ararobo/GN10Mainboard/KiCad/GN10Mainboard/kicad_lib/3dmodels/SI-60062.step

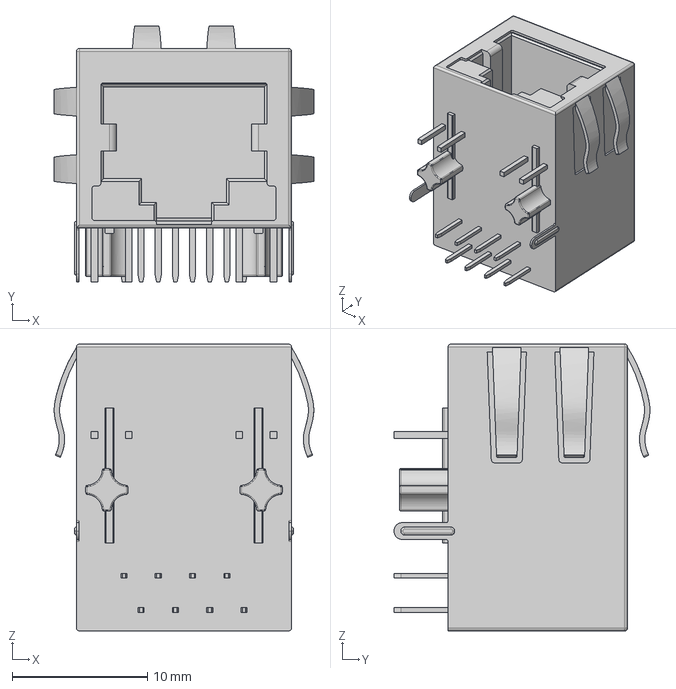
[picture p2: CAD file, 2025-08-13]
KiCad/GN10Mainboard/kicad_lib/3dmodels/SI-60062.step
19.2 x 18.9 x 21.2 mm
