ararobo/GN10Mainboard/KiCad/GN10Mainboard/kicad_lib/3dmodels/WBZ451_LGA_REV3P0-WOUFL.step

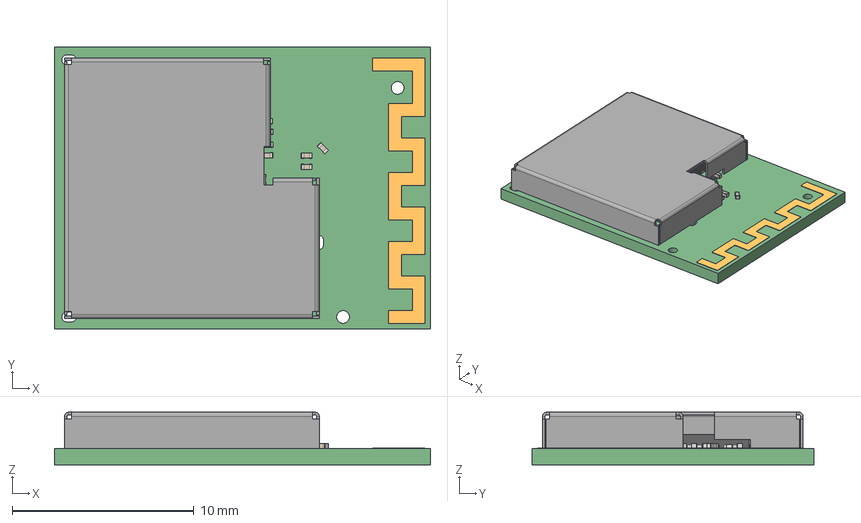
[picture p3: CAD file, 2025-01-28]
KiCad/GN10Mainboard/kicad_lib/3dmodels/WBZ451_LGA_REV3P0-WOUFL.step
20.7 x 15.5 x 2.90 mm
CAP_C_0402 x 5
User_Library-SMD_RESISTOR-10201 x 6
User_Library-Chip_Resistor2 x 3
IND_C_0402 x 2
microchip_shield_blsh_Rev04_RGB6710886
User_Library-SMD_CAPACITOR x 23
Extruded x 2
IND_C_0805
ABM11
User_Library-QFN48_7x7
