ararobo/GN10Mainboard/KiCad/GN10Mainboard/kicad_lib/3dmodels/TVAF06-A020B-R_v2.step

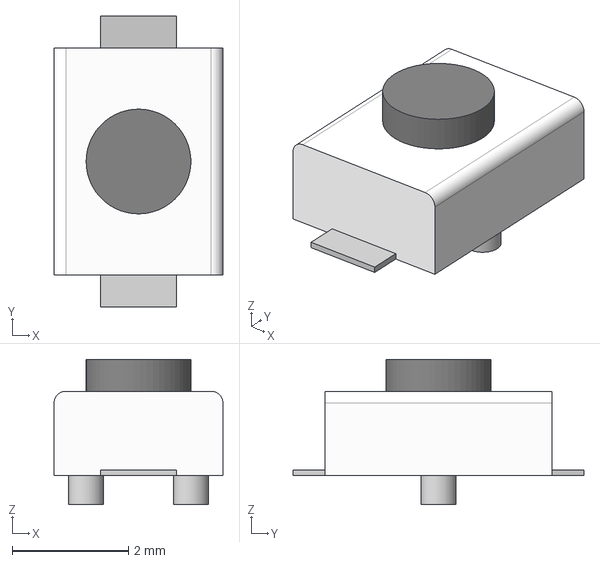
[picture p4: CAD file, 2025-01-28]
KiCad/GN10Mainboard/kicad_lib/3dmodels/TVAF06-A020B-R_v2.step
2.90 x 5.00 x 2.50 mm
