ararobo/GN10Mainboard/KiCad/GN10Mainboard/kicad_lib/3dmodels/mps_dcdc_okl_t6_a.step

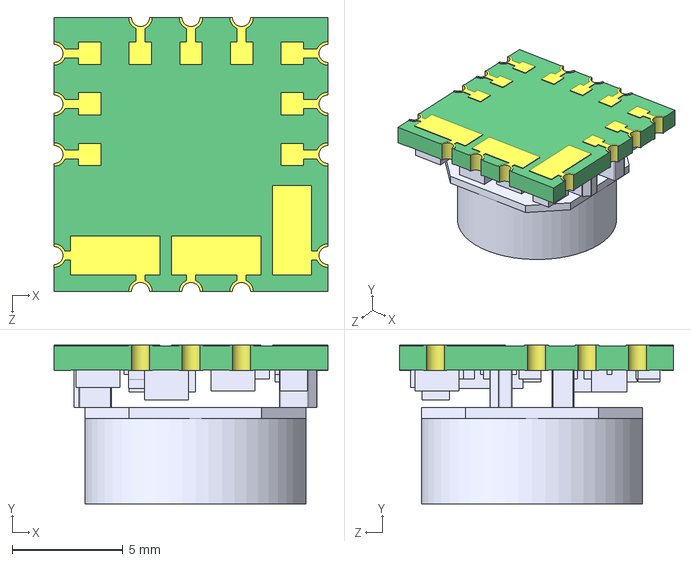
[picture p5: CAD file, 2025-01-28]
KiCad/GN10Mainboard/kicad_lib/3dmodels/mps_dcdc_okl_t6_a.step
12.4 x 7.19 x 12.4 mm
