ararobo/GN10Mainboard/KiCad/GN10Mainboard/kicad_lib/3dmodels/Type-C.STEP

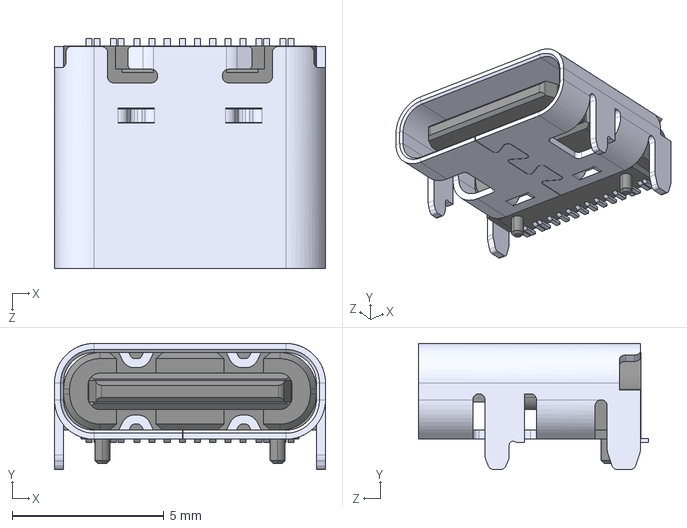
[picture p6: CAD file, 2025-01-28]
KiCad/GN10Mainboard/kicad_lib/3dmodels/Type-C.STEP
8.94 x 4.16 x 7.60 mm
