ararobo/GN10Mainboard/KiCad/GN10Mainboard/GN10Mainboard.pdf

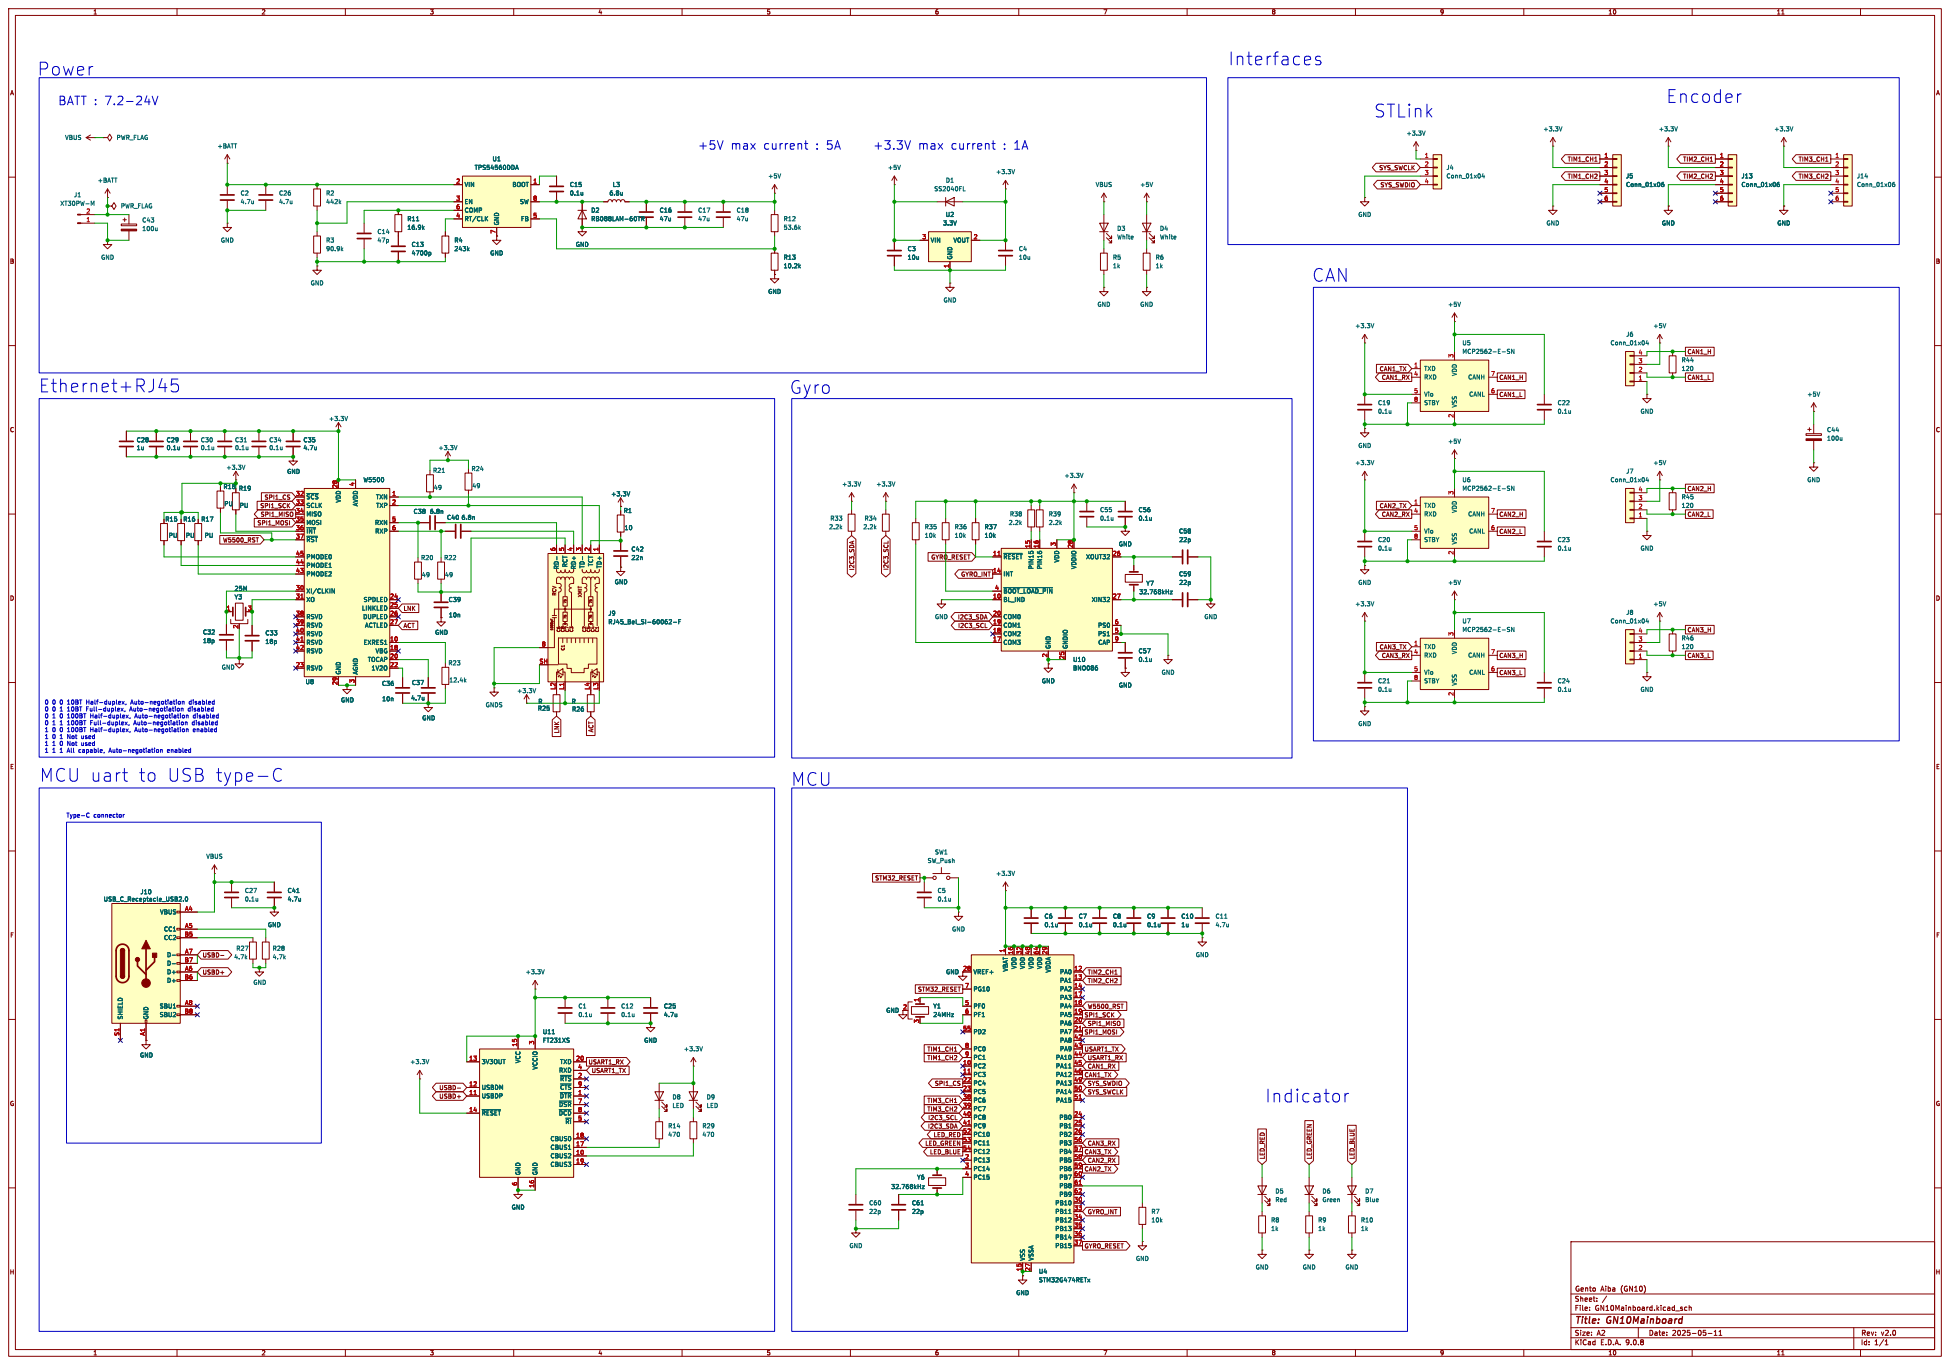
[picture p7: page 1]

3 TXN 1 TXP 2 RXN 5 RXP 6 SPDLED 24

LINKLED 25 DUPLED 26 ACTLED 27 EXRES1 10 VBG 18 TOCAP 20

1 0 1 Not used
1 1 0 Not used
MCU uart to USB type-C

1 VDD 16 VDD 32 VSS 15 VDD 48 VSSA 27 VDD 64 VDDA 29 PA0 12 PA1 13 PA2 14 PA3 17 PA4 18 PA5 19 PA6 20 PA7 21 PA8 42 PA9 43 PA10 44 PA11 45 PA12 46 PA13 49 PA14 50 PA15 51 PB0 24 PB1 25 PB2 26 PB3 56 PB4 57 PB5 58 PB6 59 PB7 60 PB8 61 PB9 62 PB10 30 PB11 33 PB12 34 PB13 35 PB14 36 PB15 37 U4STM32G474RETx

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

3 GND 16 TXD 20 RXD 4 ~{RTS}2 ~{CTS}9 ~{DTR}1 ~{DSR}7 ~{DCD}8 ~{RI}5 CBUS0 18 CBUS1 17 CBUS2 10 CBUS3 19 C25

3 GND 16 TXD 20 RXD 4 ~{RTS}2 ~{CTS}9 ~{DTR}1 ~{DSR}7 ~{DCD}8 ~{RI}5 CBUS0 18 CBUS1 17 CBUS2 10 CBUS3 19 U11 FT231XS

File: GN10Mainboard.kicad_sch Sheet: / Gento Aiba (GN10)
