ararobo/GN10Mainboard/KiCad/GN10Mainboard/GN10Mainboard.kicad_pcb

## KiCad design KiCad/GN10Mainboard/GN10Mainboard.kicad_pcb (2025-12-31)

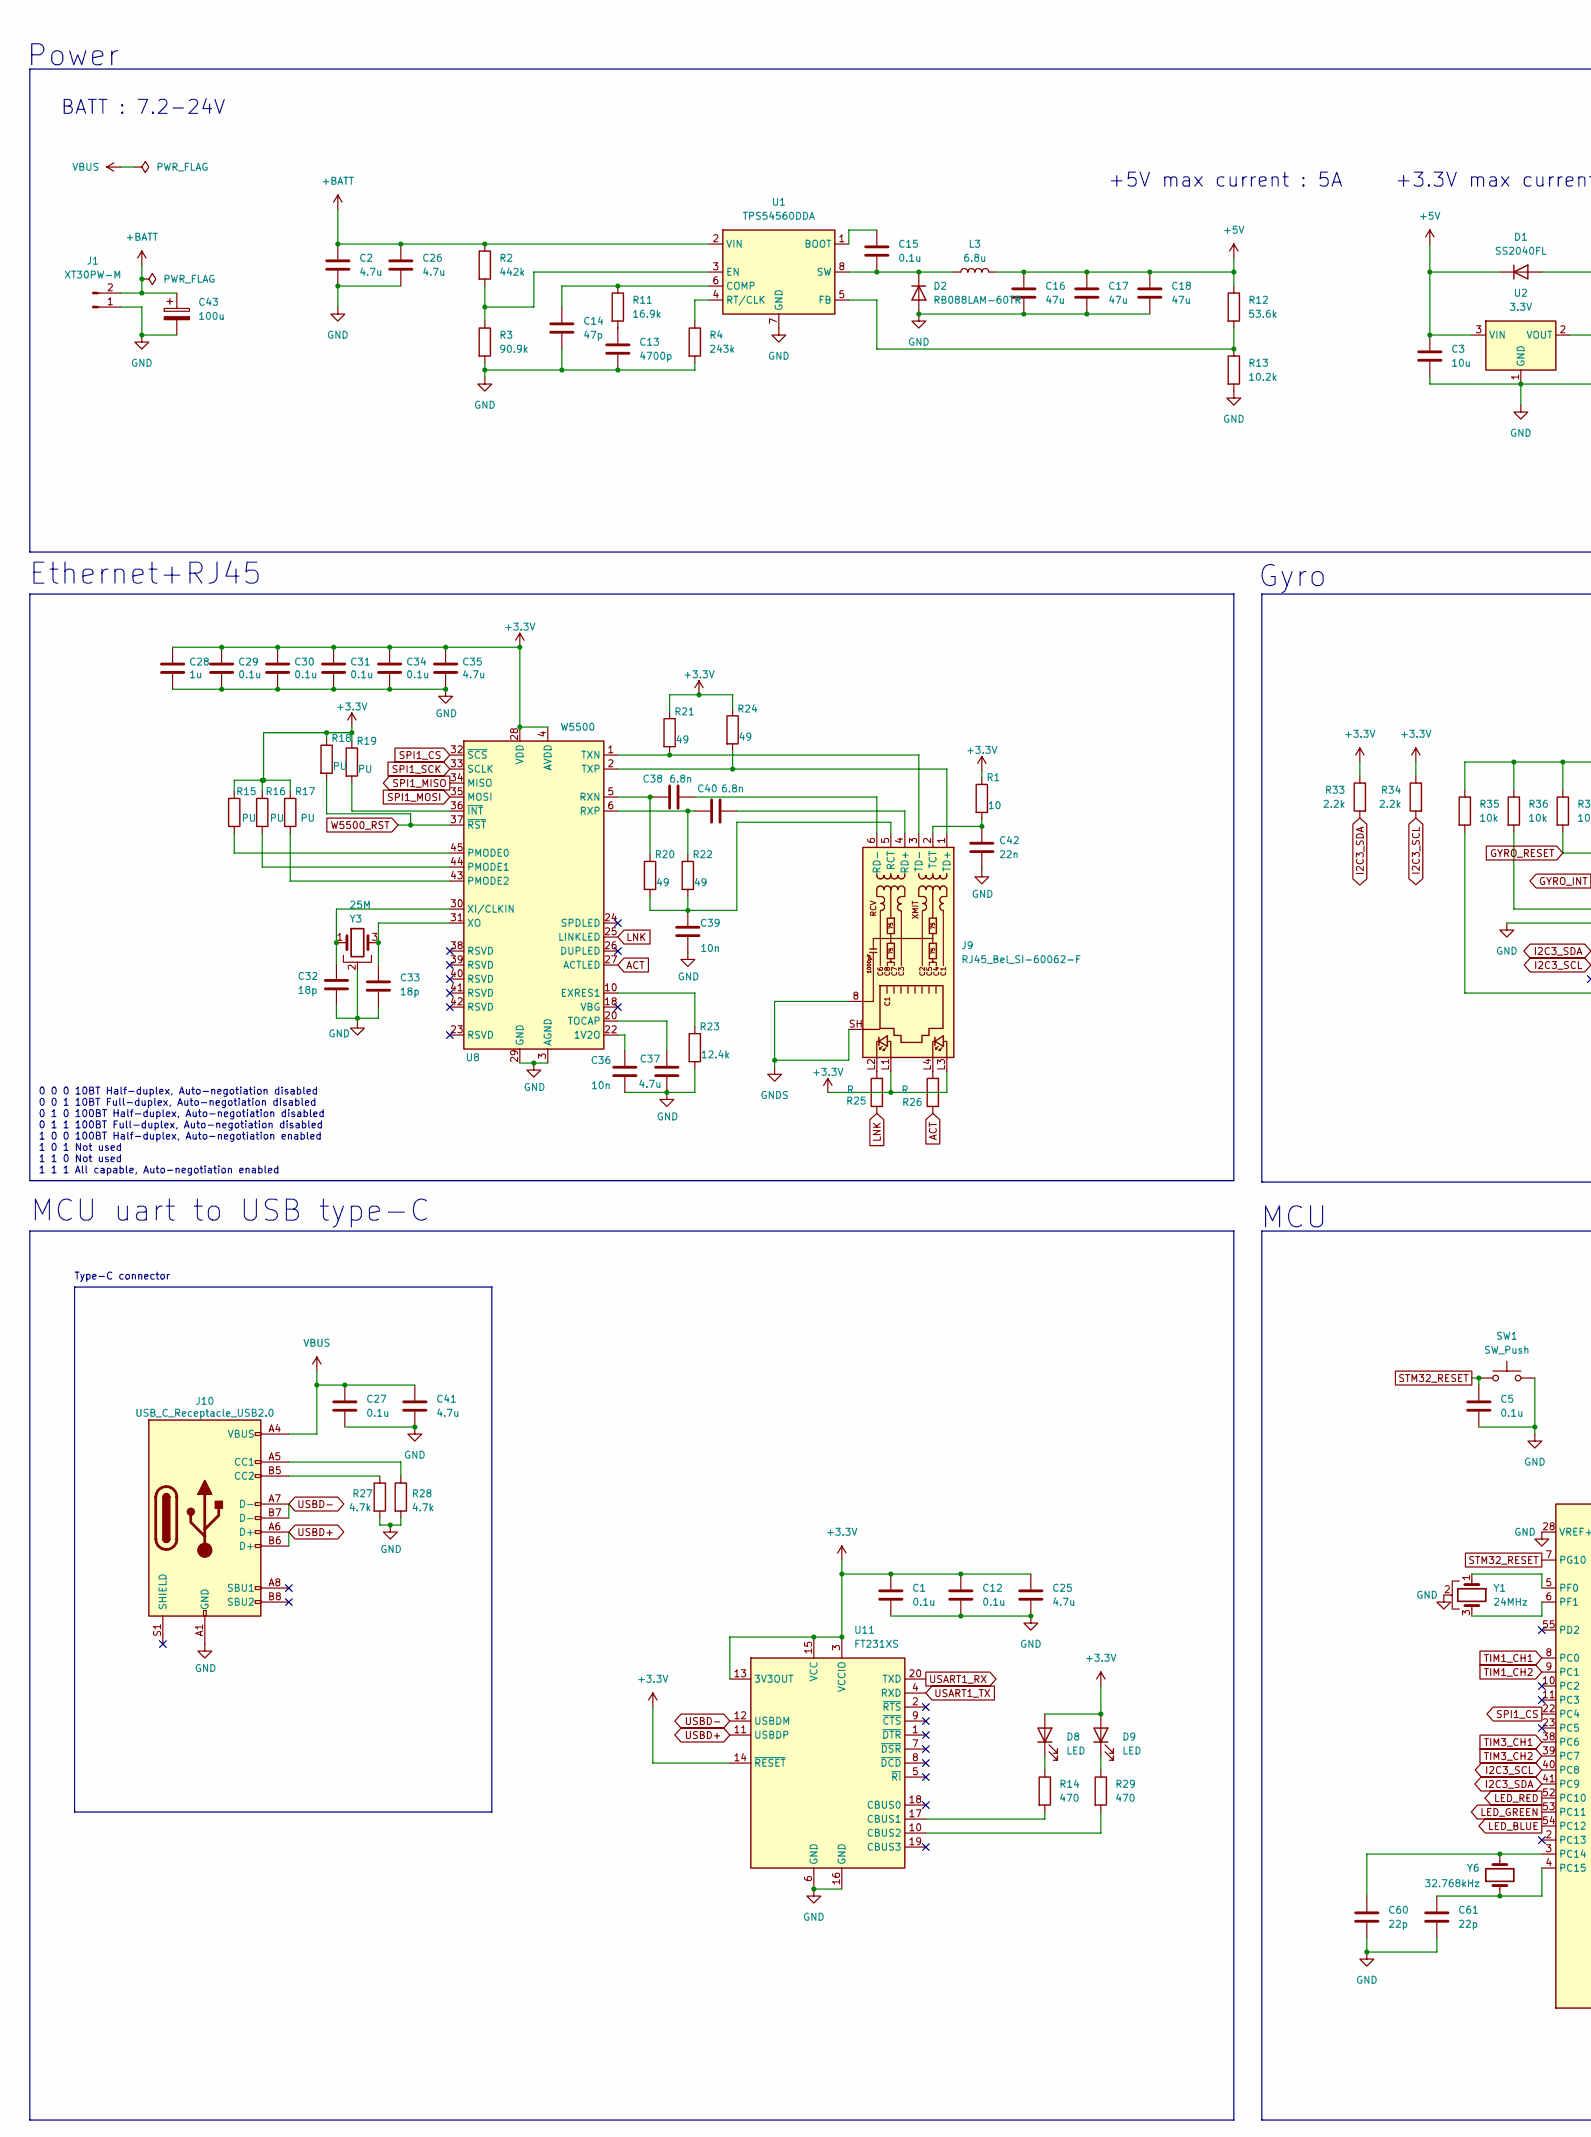
[picture p8: schematic GN10Mainboard.kicad_sch, part in row 1, column 1]

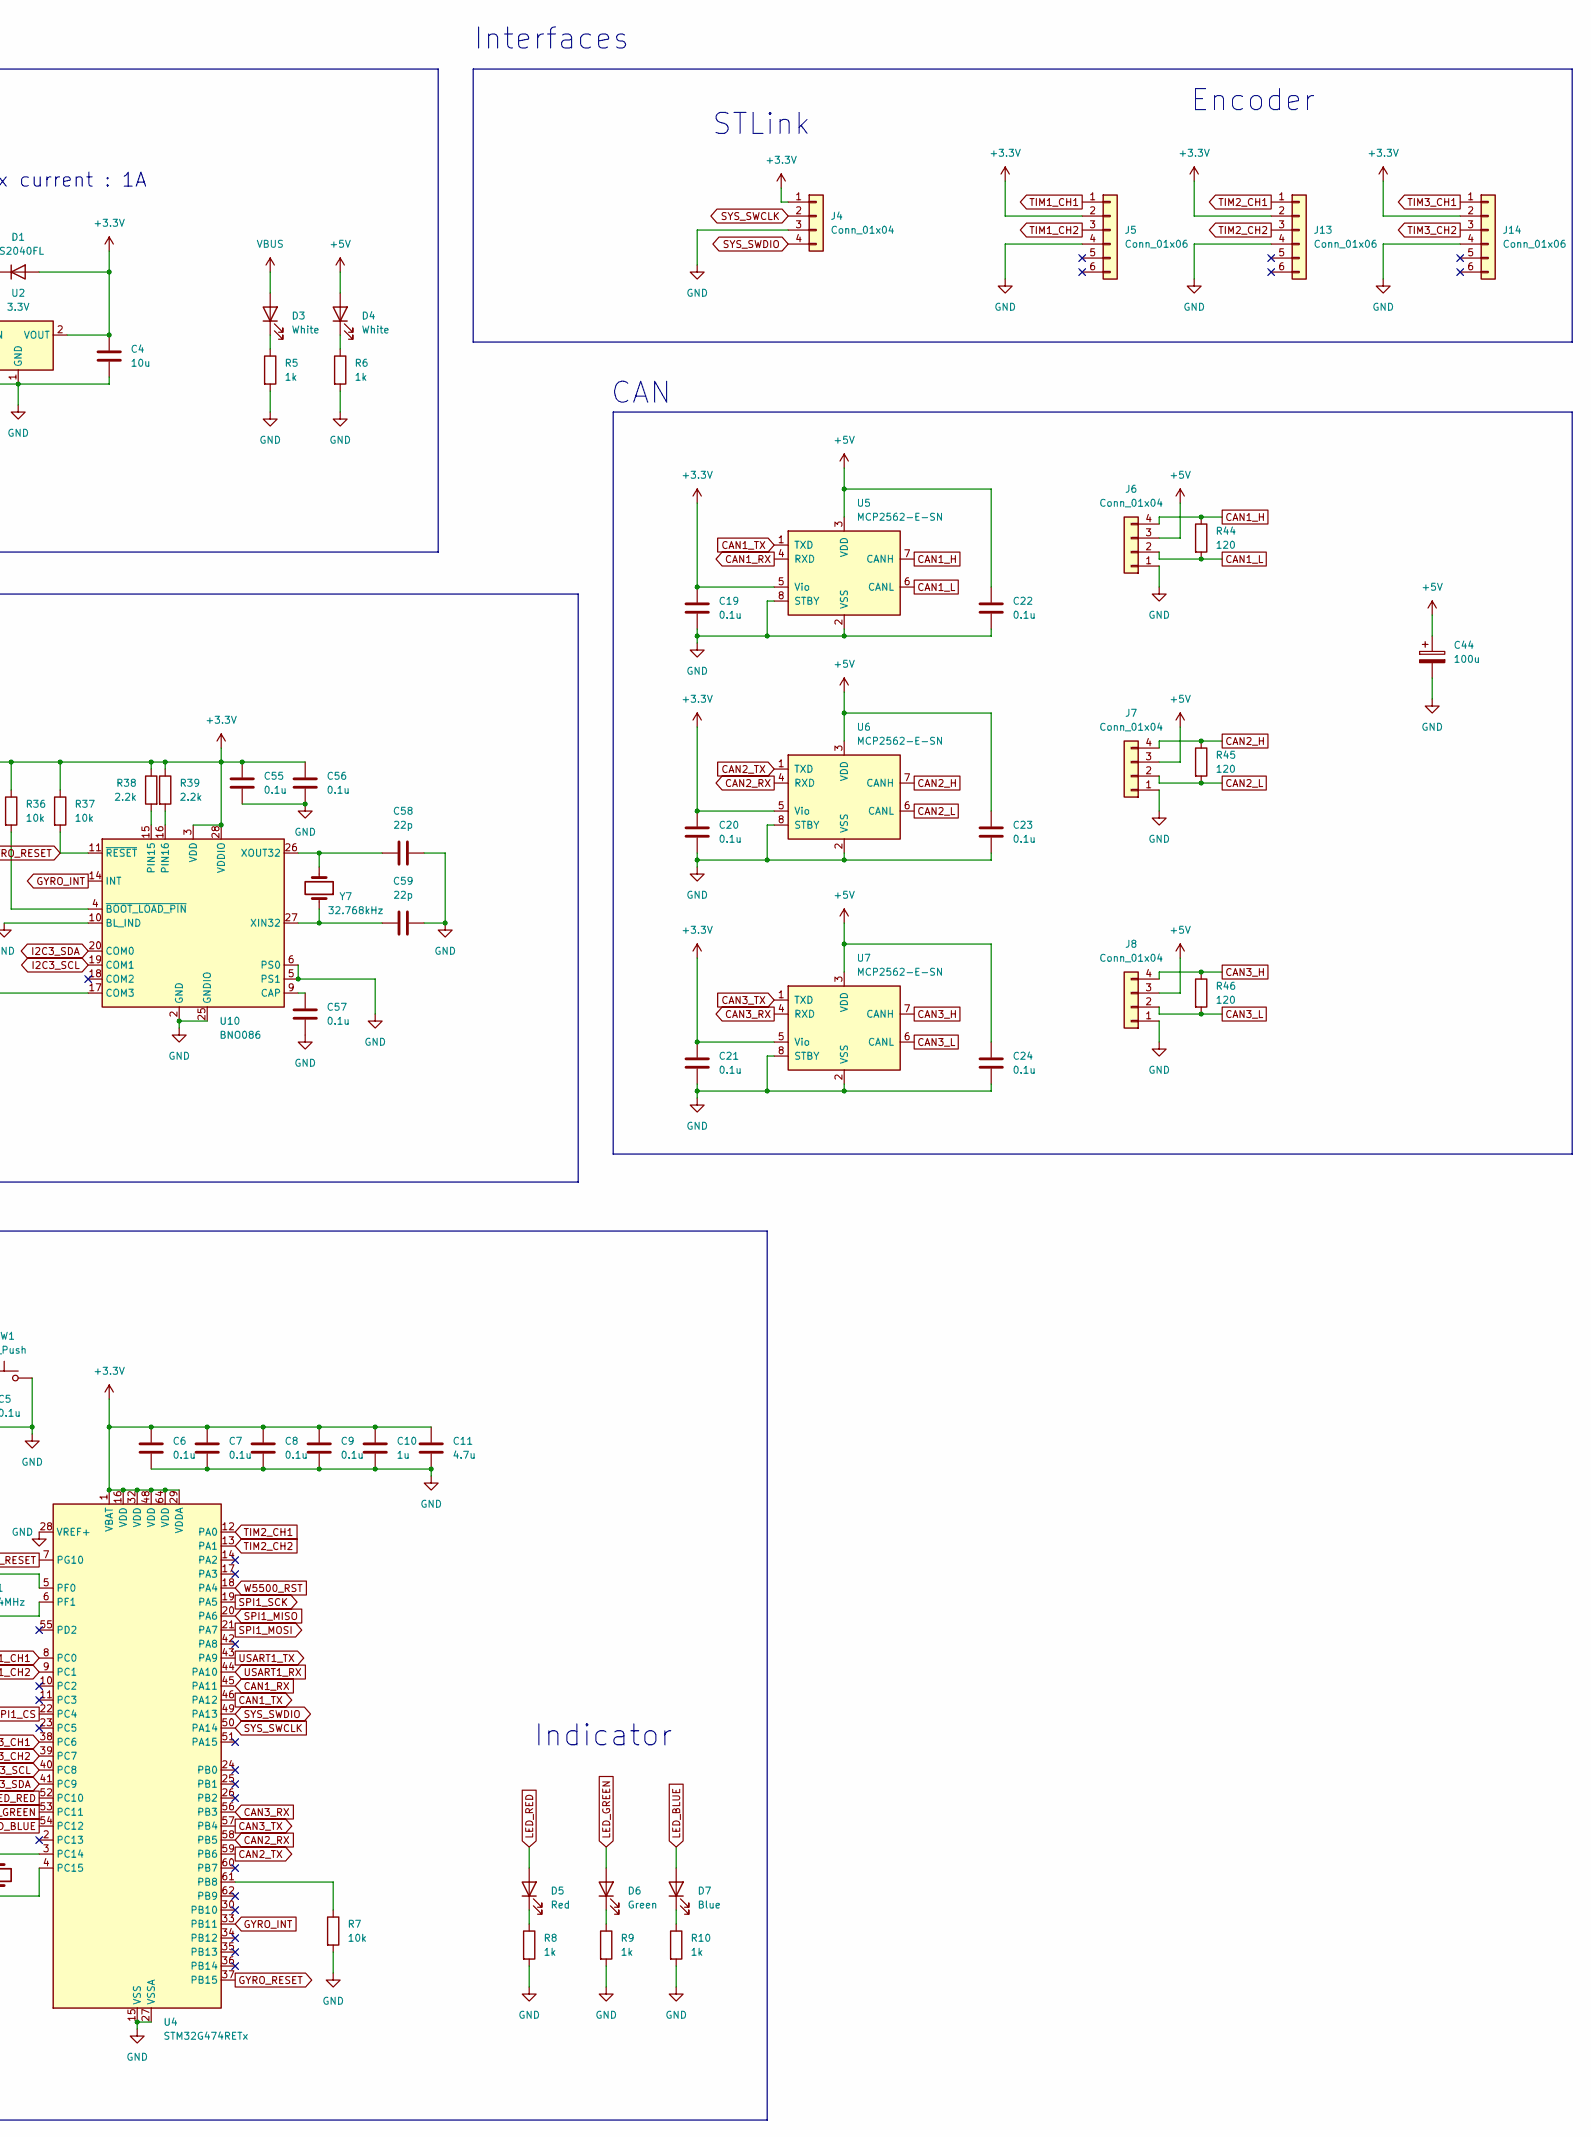
[picture p9: schematic GN10Mainboard.kicad_sch, part in row 1, column 2]

Parts:
C1, C5, C6, C7, C8, C9, C12, C15, C19, C20, C21, C22, C23, C24, C27, C29, C30, C31, C34, C55, C56, C57: 0.1u; C_0402_1005Metric
C2, C26: 4.7u; C_1210_3225Metric
C3, C4: 10u; C_0603_1608Metric
C10, C28: 1u; C_0402_1005Metric
C11, C35, C37: 4.7u; C_0402_1005Metric
C13: 4700p; C_0402_1005Metric
C14: 47p; C_0402_1005Metric
C16, C17, C18: 47u; C_1210_3225Metric
C25, C41: 4.7u; C_0603_1608Metric
C32, C33: 18p; C_0402_1005Metric
C36, C39: 10n; C_0402_1005Metric
C38, C40: 6.8n; C_0402_1005Metric
C42: 22n; C_0402_1005Metric
C43, C44: 100u; CP_Radial_D8.0mm_P3.50mm
C58, C59, C60, C61: 22p; C_0402_1005Metric
D1: SS2040FL; Nexperia_CFP3_SOD-123W
D2: RB088LAM-60TR; D_SOD-128
D3, D4: White; LED_0603_1608Metric
D5: Red; LED_0603_1608Metric
D6: Green; LED_0603_1608Metric
D7: Blue; LED_0603_1608Metric
D8, D9: LED; LED_0603_1608Metric
J1: XT30PW-M; AMASS_XT30U-M_1x02_P5.0mm_Vertical
J4, J6, J7, J8: Conn_01x04; JST_XH_B4B-XH-A_1x04_P2.50mm_Vertical
J5, J13, J14: Conn_01x06; JST_XH_B6B-XH-A_1x06_P2.50mm_Vertical
J9: RJ45_Bel_SI-60062-F
J10: USB_C_Receptacle_USB2.0; USB_C_Receptacle_HRO_TYPE-C-31-M-12
L3: 6.8u; L_Coilcraft_XAL6060-XXX
R1: 10; R_0402_1005Metric
R2: 442k; R_0402_1005Metric
R3: 90.9k; R_0402_1005Metric
R4: 243k; R_0402_1005Metric
R5, R6, R8, R9, R10: 1k; R_0402_1005Metric
R7, R35, R36, R37: 10k; R_0402_1005Metric
R11: 16.9k; R_0402_1005Metric
R12: 53.6k; R_0402_1005Metric
R13: 10.2k; R_0402_1005Metric
R14, R29: 470; R_0402_1005Metric
R15, R16, R17, R18, R19: PU; R_0402_1005Metric
R20, R21, R22, R24: 49; R_0402_1005Metric
R23: 12.4k; R_0402_1005Metric
R25, R26: R; R_0402_1005Metric
R27, R28: 4.7k; R_0402_1005Metric
R33, R34, R38, R39: 2.2k; R_0402_1005Metric
R44, R45, R46: 120; R_0402_1005Metric
SW1: SW_Push; TVAF
U1: TPS54560DDA; Texas_R-PDSO-G8_EP2.95x4.9mm_Mask2.4x3.1mm_ThermalVias
U2: 3.3V; SOT-223-3_TabPin2
U4: STM32G474RETx; LQFP-64_10x10mm_P0.5mm
U5, U6, U7: MCP2562-E-SN; SOIC-8_3.9x4.9mm_P1.27mm
U8: W5500; LQFP-48_7x7mm_P0.5mm
U10: BNO086; LGA-28_5.2x3.8mm_P0.5mm
U11: FT231XS; SSOP-20_3.9x8.7mm_P0.635mm
Y1: 24MHz; Resonator_SMD_Murata_CSTxExxV-3Pin_3.0x1.1mm
Y3: 25M; Crystal_SMD_2016-4Pin_2.0x1.6mm
Y6, Y7: 32.768kHz; Crystal_SMD_3215-2Pin_3.2x1.5mm

Connections:
+3.3V: C1.1, C4.1, C6.1, C7.1, C8.1, C9.1, C10.1, C11.1, C12.1, C19.1, C20.1, C21.1, C25.1, C28.1, C29.1, C30.1, C31.1, C34.1, C35.1, C55.1, C56.1, D1.2 (A), D8.2 (A), D9.2 (A), J4.1, J5.2, J9.L1, J9.L3, J13.2, J14.2, R1.1, R15.1, R16.1, R17.1, R18.1, R19.1, R21.1, R24.1, R33.1, R34.1, R35.1, R36.1, R37.1, R38.1, R39.1, U2.2 (VOUT), U4.1 (VBAT), U4.16 (VDD), U4.29 (VDDA), U4.32 (VDD), U4.48 (VDD), U4.64 (VDD), U5.5 (Vio), U6.5 (Vio), U7.5 (Vio), U8.4 (AVDD), U8.8 (AVDD), U8.11 (AVDD), U8.15 (AVDD), U8.17 (AVDD), U8.21 (AVDD), U8.28 (VDD), U10.3 (VDD), U10.28 (VDDIO), U11.3 (VCCIO), U11.13 (3V3OUT), U11.14 (~RESET), U11.15 (VCC)
+5V: C3.1, C16.1, C17.1, C18.1, C22.1, C23.1, C24.1, C44.1, D1.1 (K), D4.2 (A), J6.3, J7.3, J8.3, L3.2, R12.1, U2.3 (VIN), U5.3 (VDD), U6.3 (VDD), U7.3 (VDD)
+BATT: C2.1, C26.1, C43.1, J1.2, R2.1, U1.2 (VIN)
ACT: R26.1, U8.27 (ACTLED)
CAN1_H: J6.4, R44.1, U5.7 (CANH)
CAN1_L: J6.2, R44.2, U5.6 (CANL)
CAN1_RX: U4.45 (PA11), U5.4 (RXD)
CAN1_TX: U4.46 (PA12), U5.1 (TXD)
CAN2_H: J7.4, R45.1, U6.7 (CANH)
CAN2_L: J7.2, R45.2, U6.6 (CANL)
CAN2_RX: U4.58 (PB5), U6.4 (RXD)
CAN2_TX: U4.59 (PB6), U6.1 (TXD)
CAN3_H: J8.4, R46.1, U7.7 (CANH)
CAN3_L: J8.2, R46.2, U7.6 (CANL)
CAN3_RX: U4.56 (PB3), U7.4 (RXD)
CAN3_TX: U4.57 (PB4), U7.1 (TXD)
GND: C1.2, C2.2, C3.2, C4.2, C5.2, C6.2, C7.2, C8.2, C9.2, C10.2, C11.2, C12.2, C13.2, C14.2, C16.2, C17.2, C18.2, C19.2, C20.2, C21.2, C22.2, C23.2, C24.2, C25.2, C26.2, C27.2, C28.2, C29.2, C30.2, C31.2, C32.2, C33.2, C34.2, C35.2, C36.2, C37.2, C39.2, C41.2, C42.2, C43.2, C44.2, C55.2, C56.2, C57.2, C58.2, C59.2, C60.1, C61.1, D2.2 (A), J1.1, J4.3, J5.4, J6.1, J7.1, J8.1, J10.A1 (GND), J10.A12 (GND), J10.B1 (GND), J10.B12 (GND), J13.4, J14.4, R3.2, R4.2, R5.2, R6.2, R7.2, R8.2, R9.2, R10.2, R13.2, R23.2, R27.2, R28.2, SW1.2, U1.7 (GND), U1.9 (GND), U2.1 (GND), U4.15 (VSS), U4.27 (VSSA), U4.28 (VREF+), U4.31 (VSS), U4.47 (VSS), U4.63 (VSS), U5.2 (VSS), U5.8 (STBY), U6.2 (VSS), U6.8 (STBY), U7.2 (VSS), U7.8 (STBY), U8.3 (AGND), U8.9 (AGND), U8.14 (AGND), U8.16 (AGND), U8.19 (AGND), U8.29 (GND), U8.48 (AGND), U10.2 (GND), U10.5 (PS1), U10.6 (PS0), U10.10 (BL_IND), U10.25 (GNDIO), U11.6 (GND), U11.16 (GND), Y1.2, Y3.2
GNDS: J9.8, J9.SH
GYRO_INT: U4.33 (PB11), U10.14 (INT)
GYRO_RESET: R37.2, U4.37 (PB15), U10.11 (~RESET)
I2C3_SCL: R34.2, U4.40 (PC8), U10.19 (COM1)
I2C3_SDA: R33.2, U4.41 (PC9), U10.20 (COM0)
LED_BLUE: D7.2 (A), U4.54 (PC12)
LED_GREEN: D6.2 (A), U4.53 (PC11)
LED_RED: D5.2 (A), U4.52 (PC10)
LNK: R25.1, U8.25 (LINKLED)
unnamed: C13.1, R11.2
unnamed: C15.2, D2.1 (K), L3.1, U1.8 (SW)
unnamed: D3.1 (K), R5.1
unnamed: D4.1 (K), R6.1
unnamed: D5.1 (K), R8.1
unnamed: D6.1 (K), R9.1
unnamed: D7.1 (K), R10.1
unnamed: D8.1 (K), R14.1
unnamed: D9.1 (K), R29.1
unnamed: J9.L2, R25.2
unnamed: J9.L4, R26.2
unnamed: C39.1, J9.5 (RCT), R20.2, R22.2
unnamed: C40.2, J9.4 (RD+)
unnamed: C38.1, J9.6 (RD-)
unnamed: C42.1, J9.2 (TCT), R1.2
unnamed: J9.1 (TD+), R24.2, U8.2 (TXP)
unnamed: J9.3 (TD-), R21.2, U8.1 (TXN)
unnamed: J10.A5 (CC1), R28.1
unnamed: J10.B5 (CC2), R27.1
unnamed: C15.1, U1.1 (BOOT)
unnamed: C14.1, R11.1, U1.6 (COMP)
unnamed: R2.2, R3.1, U1.3 (EN)
unnamed: R12.2, R13.1, U1.5 (FB)
unnamed: R4.1, U1.4 (RT/CLK)
unnamed: R7.1, U4.61 (PB8)
unnamed: C60.2, U4.3 (PC14), Y6.2
unnamed: C61.2, U4.4 (PC15), Y6.1
unnamed: U4.5 (PF0), Y1.1
unnamed: U4.6 (PF1), Y1.3
unnamed: C36.1, U8.22 (1V2O)
unnamed: R23.1, U8.10 (EXRES1)
unnamed: R15.2, U8.45 (PMODE0)
unnamed: R16.2, U8.44 (PMODE1)
unnamed: R17.2, U8.43 (PMODE2)
unnamed: C38.2, R20.1, U8.5 (RXN)
unnamed: C40.1, R22.1, U8.6 (RXP)
unnamed: C37.1, U8.20 (TOCAP)
unnamed: C32.1, U8.30 (XI/CLKIN), Y3.1
unnamed: C33.1, U8.31 (XO), Y3.3
unnamed: R19.2, U8.36 (~INT)
unnamed: C57.1, U10.9 (CAP)
unnamed: R35.2, U10.17 (COM3)
unnamed: R38.2, U10.15 (PIN15)
unnamed: R39.2, U10.16 (PIN16)
unnamed: C59.1, U10.27 (XIN32), Y7.1
unnamed: C58.1, U10.26 (XOUT32), Y7.2
unnamed: R36.2, U10.4 (~BOOT_LOAD_PIN)
unnamed: R14.2, U11.17 (CBUS1)
unnamed: R29.2, U11.10 (CBUS2)
SPI1_CS: U4.22 (PC4), U8.32 (~SCS)
SPI1_MISO: U4.20 (PA6), U8.34 (MISO)
SPI1_MOSI: U4.21 (PA7), U8.35 (MOSI)
SPI1_SCK: U4.19 (PA5), U8.33 (SCLK)
STM32_RESET: C5.1, SW1.1, U4.7 (PG10)
SYS_SWCLK: J4.2, U4.50 (PA14)
SYS_SWDIO: J4.4, U4.49 (PA13)
TIM1_CH1: J5.1, U4.8 (PC0)
TIM1_CH2: J5.3, U4.9 (PC1)
TIM2_CH1: J13.1, U4.12 (PA0)
TIM2_CH2: J13.3, U4.13 (PA1)
TIM3_CH1: J14.1, U4.38 (PC6)
TIM3_CH2: J14.3, U4.39 (PC7)
USART1_RX: U4.44 (PA10), U11.20 (TXD)
USART1_TX: U4.43 (PA9), U11.4 (RXD)
USBD+: J10.A6 (D+), J10.B6 (D+), U11.11 (USBDP)
USBD-: J10.A7 (D-), J10.B7 (D-), U11.12 (USBDM)
VBUS: C27.1, C41.1, D3.2 (A), J10.A4 (VBUS), J10.A9 (VBUS), J10.B4 (VBUS), J10.B9 (VBUS)
W5500_RST: R18.2, U4.18 (PA4), U8.37 (~RST)

Notes on the sheet:
Type-C connector
0 0 0 10BT Half-duplex, Auto-negotiation disabled 0 0 1 10BT Full-duplex, Auto-negotiation disabled 0 1 0 100BT Half-duplex, Auto-negotiation disabled 0 1 1 100BT Full-duplex, Auto-negotiation disabled 1 0 0 100BT Half-duplex, Auto-negotiation enabled 1 0 1 Not used 1 1 0 Not used 1 1 1 All capable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
BATT : 7.2-24V
Power
Gyro
STLink
Encoder
Indicator
MCU uart to USB type-C
Interfaces
Ethernet+RJ45
MCU
CAN
+3.3V max current : 1A
+5V max current : 5A

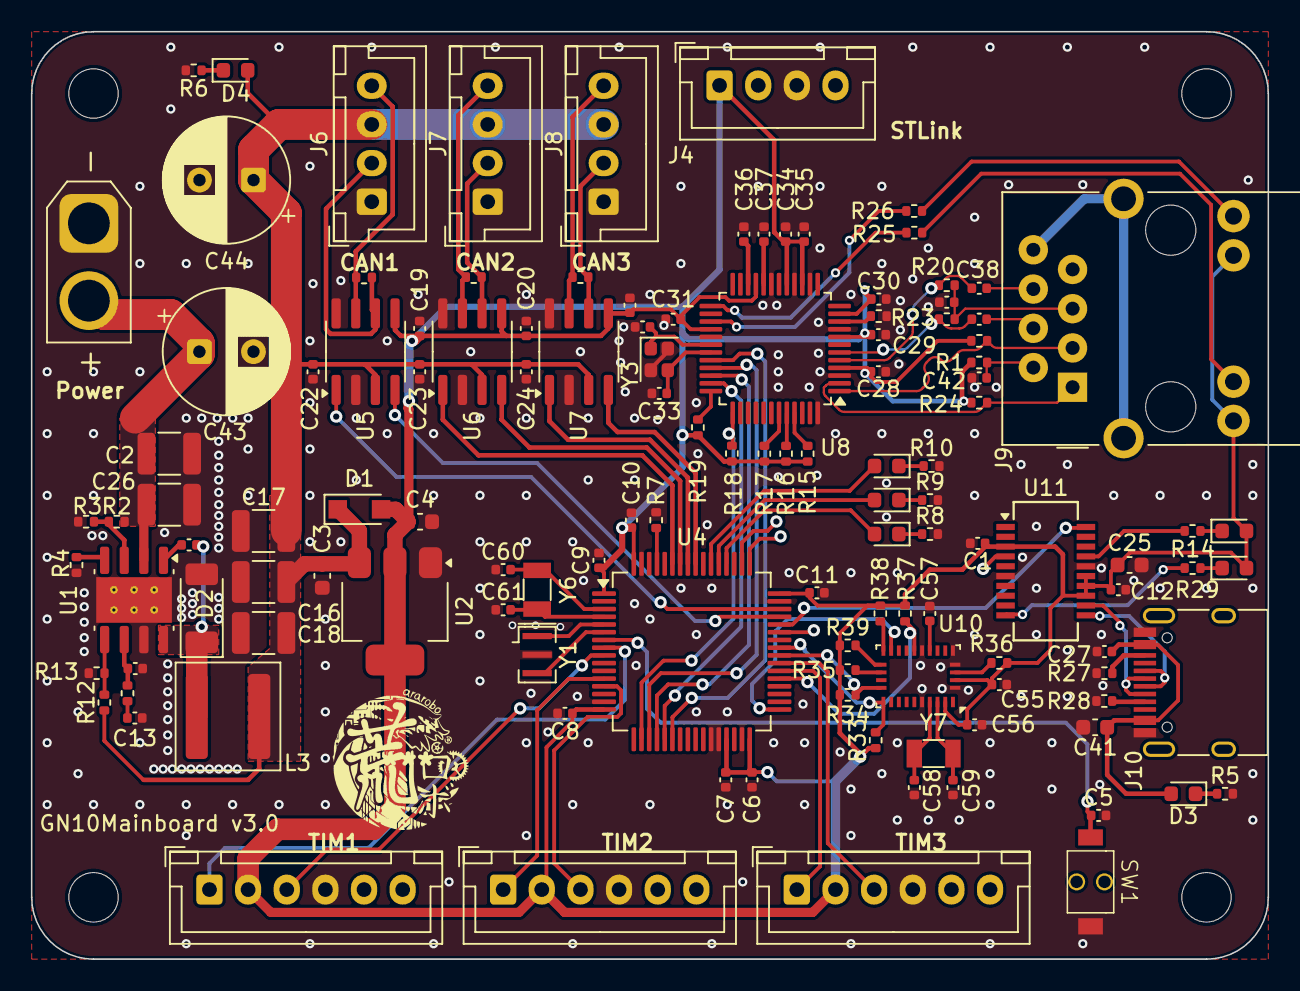
[picture p10: board GN10Mainboard.kicad_pcb from above]

Board: 4 copper layers, 80.0 x 60.0 mm, 124 parts (0 on the bottom side), 94 nets.
