ararobo/GN10Mainboard/Firmware/GN10Mainboard/GN10Mainboard.ioc

Mcu.UserName=STM32G474RCTx
PA0.Signal=S_TIM2_CH1
PA1.Signal=S_TIM2_CH2
PA10.Signal=USART1_RX
PA11.Signal=FDCAN1_RX
PA12.Signal=FDCAN1_TX
PA13.Signal=SYS_JTMS-SWDIO
PA14.Signal=SYS_JTCK-SWCLK
PA2.Signal=USART2_TX
PA3.Signal=USART2_RX
PA4.GPIO_Label=W5500_RST
PA4.Signal=GPIO_Output
PA5.Signal=SPI1_SCK
PA6.Signal=SPI1_MISO
PA7.Signal=SPI1_MOSI
PA9.Signal=USART1_TX
PB0.GPIO_Label=BLE_UART_MODE
PB0.Signal=GPIO_Output
PB11.GPIO_Label=GYRO_INT
PB11.Signal=GPIO_Input
PB12.GPIO_Label=LED_RED
PB12.Signal=GPIO_Output
PB13.GPIO_Label=LED_GREEN
PB13.Signal=GPIO_Output
PB14.GPIO_Label=LED_BLUE
PB14.Signal=GPIO_Output
PB3.Signal=FDCAN3_RX
PB4.Signal=FDCAN3_TX
PB5.Signal=FDCAN2_RX
PB6.Signal=FDCAN2_TX
PC0.Signal=S_TIM1_CH1
PC1.Signal=S_TIM1_CH2
PC10.GPIO_Label=SW1
PC10.Signal=GPIO_Input
PC11.GPIO_Label=SW2
PC11.Signal=GPIO_Input
PC12.GPIO_Label=SW3
PC12.Signal=GPIO_Input
PC14-OSC32_IN.Signal=RCC_OSC32_IN
PC15-OSC32_OUT.Signal=RCC_OSC32_OUT
PC4.GPIO_Label=SPI1_CS
PC4.Signal=GPIO_Output
PC6.Signal=S_TIM3_CH1
PC7.Signal=S_TIM3_CH2
PC8.Signal=I2C3_SCL
PC9.Signal=I2C3_SDA
PF0-OSC_IN.Signal=RCC_OSC_IN
PF1-OSC_OUT.Signal=RCC_OSC_OUT
