ararobo/GN10Mainboard/(commit log)

2025-01-15 方針を決めるために、特徴や部品をREADMEに明記した。
2025-01-15 KiCadのプロジェクトを作成した。STM32の型番が間違っていたのでREADMEを修正。
    [GN10Mainboard.kicad_pcb, GN10Mainboard.kicad_sch]
2025-01-16 Changed language to English.
    [GN10Mainboard.kicad_sch]
2025-01-16 In progress. (I wired the area around the MCU and DCDC converter.)
    [GN10Mainboard.kicad_sch]
2025-01-17 I wired around the BLE module.
    [GN10Mainboard.kicad_sch]
2025-01-18 I wired around two FT232XS.
    [GN10Mainboard.kicad_sch]
2025-01-18 I created an STM32-ioc file. I also thought about the PCB.
    [GN10Mainboard.kicad_pcb, GN10Mainboard.kicad_sch]
2025-01-19 Update: STM32-ioc, Wired: 7segLED/Jumper/STM32
    [GN10Mainboard.kicad_pcb, GN10Mainboard.kicad_sch]
2025-01-21 fix: connection between the MCU to connectors.
    [GN10Mainboard.kicad_pcb, GN10Mainboard.kicad_sch]
2025-01-21 Circuit diagram completed!
    [GN10Mainboard.kicad_sch]
2025-01-21 add: USB power supply switch for 5V.
    [GN10Mainboard.kicad_sch]
2025-01-21 update: schematic pdf
2025-01-21 fix: around DCDC convertor
    [GN10Mainboard.kicad_sch]
2025-01-21 update: schematic
2025-01-21 The DCDC does not require a reverse voltage protection diode, so I removed it.
    [GN10Mainboard.kicad_sch]
2025-01-21 Added a reverse voltage protection diode to the linear regulator and fixed the 7seg LED because its resistance was too high.
    [GN10Mainboard.kicad_sch]
2025-01-22 add: transistor array for drive a 7 segment LED.
    [GN10Mainboard.kicad_sch]
2025-01-22 update: pdf and anotation
    [GN10Mainboard.kicad_sch]
2025-01-22 fix: anotation
    [GN10Mainboard.kicad_sch]
2025-01-22 change from FT231XS to FT2232HQ
    [GN10Mainboard.kicad_pcb, GN10Mainboard.kicad_sch]
2025-01-22 fix: arround FT2232HQ
    [GN10Mainboard.kicad_pcb, GN10Mainboard.kicad_sch]
2025-01-23 in progress.
    [GN10Mainboard.kicad_pcb, GN10Mainboard.kicad_sch]
2025-01-24 replace: PCB
    [GN10Mainboard.kicad_pcb]
2025-01-25 I placed parts.
    [GN10Mainboard.kicad_pcb, GN10Mainboard.kicad_sch]
2025-01-25 PCB: I wired 70% of parts but placement is bad. So I'll redo.
    [GN10Mainboard.kicad_pcb, GN10Mainboard.kicad_sch]
2025-01-26 Wiring complete
    [GN10Mainboard.kicad_pcb, GN10Mainboard.kicad_sch]
2025-01-27 update ioc and clean chematic for v1.0
    [GN10Mainboard.kicad_sch]
2025-01-28 PCB: parts placed
    [GN10Mainboard.kicad_pcb, GN10Mainboard.kicad_sch]
2025-01-28 PCB: wired all parts
    [GN10Mainboard.kicad_pcb, GN10Mainboard.kicad_sch, TVAF06-A020B-R_v2.step, Type-C.STEP, WBZ451_LGA_REV3P0-WOUFL.step, mps_dcdc_okl_t6_a.step]
2025-01-28 add: silkscreen
    [GN10Mainboard.kicad_pcb, GN10Mainboard.kicad_sch]
2025-01-29 generated: gerber
    [GN10Mainboard.kicad_pcb]
2025-01-29 update: gerber & silkscreen
    [GN10Mainboard.kicad_pcb]
2025-02-04 Optimized PCB layout for better noise suppression
    [GN10Mainboard-B_Cu.gbr, GN10Mainboard-B_Mask.gbr, GN10Mainboard-B_Paste.gbr, GN10Mainboard-B_Silkscreen.gbr, GN10Mainboard-Edge_Cuts.gbr, GN10Mainboard-F_Cu.gbr, GN10Mainboard-F_Mask.gbr, GN10Mainboard-F_Paste.gbr]
2025-02-04 fix: names
    [GN10Mainboard-B_Cu.gbr, GN10Mainboard-B_Mask.gbr, GN10Mainboard-B_Paste.gbr, GN10Mainboard-B_Silkscreen.gbr, GN10Mainboard-Edge_Cuts.gbr, GN10Mainboard-F_Cu.gbr, GN10Mainboard-F_Mask.gbr, GN10Mainboard-F_Paste.gbr]
2025-02-04 2layer PCB version
    [GN10Mainboard-B_Cu.gbr, GN10Mainboard-B_Mask.gbr, GN10Mainboard-B_Paste.gbr, GN10Mainboard-B_Silkscreen.gbr, GN10Mainboard-Edge_Cuts.gbr, GN10Mainboard-F_Cu.gbr, GN10Mainboard-F_Mask.gbr, GN10Mainboard-F_Paste.gbr]
2025-02-05 fix: PCB design rules.
    [GN10Mainboard-B_Cu.gbr, GN10Mainboard-B_Mask.gbr, GN10Mainboard-B_Paste.gbr, GN10Mainboard-B_Silkscreen.gbr, GN10Mainboard-Edge_Cuts.gbr, GN10Mainboard-F_Cu.gbr, GN10Mainboard-F_Mask.gbr, GN10Mainboard-F_Paste.gbr]
2025-03-30 fix:CAN tx/rx pin & silkscreen
    [GN10Mainboard-B_Cu.gbr, GN10Mainboard-B_Mask.gbr, GN10Mainboard-B_Paste.gbr, GN10Mainboard-B_Silkscreen.gbr, GN10Mainboard-Edge_Cuts.gbr, GN10Mainboard-F_Cu.gbr, GN10Mainboard-F_Mask.gbr, GN10Mainboard-F_Paste.gbr]
2025-04-02 enable:uart it
2025-04-02 uart bypass
2025-04-02 uart bypass success
2025-05-11 update:pin config, add:SPI,FDCAN1
    [GN10Mainboard.kicad_sch]
2025-05-11 fix:tag error, remove:files
    [GN10Mainboard-B_Cu.gbr, GN10Mainboard-B_Mask.gbr, GN10Mainboard-B_Paste.gbr, GN10Mainboard-B_Silkscreen.gbr, GN10Mainboard-Edge_Cuts.gbr, GN10Mainboard-F_Cu.gbr, GN10Mainboard-F_Mask.gbr, GN10Mainboard-F_Paste.gbr]
2025-05-17 PCB:配置
    [GN10Mainboard.kicad_pcb, GN10Mainboard.kicad_sch]
2025-08-13 add:3D models
    [GN10Mainboard.kicad_pcb, SI-60062.step]
2025-10-16 W55500周りの電源の修正
    [GN10Mainboard.kicad_pcb, GN10Mainboard.kicad_sch]
2025-10-16 update:gaber, silkscreen
    [GN10Mainboard.kicad_pcb]
2025-10-18 update:TCT RCT
    [GN10Mainboard.kicad_pcb, GN10Mainboard.kicad_sch]
2025-12-16 remove:parts and PCB
    [GN10Mainboard.kicad_pcb, GN10Mainboard.kicad_sch]
2025-12-18 add:DCDC conv symbol
    [GN10Mainboard.kicad_sch]
2025-12-24 add:Jetson connectors
    [GN10Mainboard.kicad_sch]
2025-12-24 remove:jetson connectors
    [GN10Mainboard.kicad_sch]
2025-12-24 update:Serial conv to ft231xs
    [GN10Mainboard.kicad_sch]
2025-12-24 add:footprint to serial-conv
    [GN10Mainboard.kicad_sch]
2025-12-25 update:board size
    [GN10Mainboard.kicad_pcb]
2025-12-25 update:parts place
    [GN10Mainboard.kicad_pcb]
2025-12-28 update:replace compornent
    [GN10Mainboard.kicad_pcb]
2025-12-29 update:compornents placement
    [GN10Mainboard.kicad_pcb, GN10Mainboard.kicad_sch]
2025-12-29 update:components placement
    [GN10Mainboard.kicad_pcb]
2025-12-29 add:DC/DC wiring
    [GN10Mainboard.kicad_pcb]
2025-12-30 add:SPI wiring
    [GN10Mainboard.kicad_pcb]
2025-12-30 update:GND zorn
    [GN10Mainboard.kicad_pcb]
2025-12-30 fix:feedback wire
    [GN10Mainboard.kicad_pcb]
2025-12-30 update:wired all components
    [GN10Mainboard.kicad_pcb]
2025-12-30 update:silkscreen placement
    [GN10Mainboard.kicad_pcb]
2026-03-21 docs:add schematic pdf
